Servayejc/Hardware/Parts.xlsx

Sheet: Sheet1
# | Value | DK | Tot
C1 | 0.1uF | Digi-Key 478-1831-ND | 1 | Découplage alim analog I/O
C12 | 0.1uF | Digi-Key 478-1831-ND | 1 | Découplage alimentation
C17 | 0.1uF | Digi-Key 478-1831-ND | 1 | Découplage alimentation
C3 | 0.1uF | Digi-Key 478-1831-ND | 1 | Découplage alimentation
C4 | 0.1uF | Digi-Key 478-1831-ND | 1 | Découplage alimentation
C5 | 0.1uF | Digi-Key 478-1831-ND | 1 | Découplage alimentation
C6 | 0.1uF | Digi-Key 478-1831-ND | 1 | Découplage alimentation
C8 | 0.1uF | Digi-Key 718-1208-ND | 1 | Découplage alimentation
 | 0.1uF Total |  | 8
C13 | 100nF | Digi-Key BC1621-ND | 1 | Découplage Ethernet
C14 | 100nF | Digi-Key BC1621-ND | 1 | Découplage Ethernet
C2 | 100nF | Digi-Key BC1621-ND | 1 | Reset par le port série
 | 100nF Total |  | 3
R24 | 10K |  | 1 | Pull-up interrupt Ethernet
 | 10K Total |  | 1
C15 | 15pF |  | 1 | Oscillateur Ethernet
C16 | 15pF |  | 1 | Oscillateur Ethernet
 | 15pF Total |  | 2
X2 | 16MHz | Digi-Key X1103-ND | 1 | Oscillateur Processeur
 | 16MHz Total |  | 1
R18 | 18R |  | 1 | Alimentation Ethernet
 | 18R Total |  | 1
R13 | 1K |  | 1 | Limitation courant LED
R14 | 1K |  | 1 | N/A
 | 1K Total |  | 2
R11 | 220R |  | 1 | Limitation courant LED
R21 | 220R |  | 1 | Limitation courant LED
R22 | 220R |  | 1 | Limitation courant LED
R7 | 220R |  | 1 | Limitation courant LED
R8 | 220R |  | 1 | Limitation courant LED
R9 | 220R |  | 1 | Découplage alim analog I/O
 | 220R Total |  | 6
C10 | 22pF |  | 1 | Oscillateur processeur
C11 | 22pF |  | 1 | Oscillateur processeur
 | 22pF Total |  | 2
X3 | 25MHz | Digi-Key X1103-ND | 1 | Oscillateur Ethernet
 | 25MHz Total |  | 1
R4 | 2K2 |  | 1 | Pull-up one-wire
R5 | 2K2 |  | 1 | Pull-up one-wire
 | 2K2 Total |  | 2
R23 | 2K4 |  | 1 | Polarisation Ethernet
 | 2K4 Total |  | 1
Q3 | 2N2222 | Digi-Key P2N2222AGOS-ND | 1 | Contrôle LED DO13
 | 2N2222 Total |  | 1
B1 | 3.3v | Digi-Key P033-ND = BAT-HLD-012-THM-ND | 1 | Batterie RTC
 | 3.3v Total |  | 1
X1 | 32768 KHz | DigiKey 728-1000-ND | 1 | Oscillateur RTC
 | 32768 KHz Total |  | 1
R16 | 47R |  | 1 | Polarisation Ethernet
R17 | 47R |  | 1 | Polarisation Ethernet
R19 | 47R |  | 1 | Polarisation Ethernet
R20 | 47R |  | 1 | Polarisation Ethernet
 | 47R Total |  | 4
C7 | 47uF | Digi-Key 399-3661-ND | 1 | Découplage alim 12V
C9 | 47uF | Digi-Key 399-3661-ND | 1 | Découplage alim Ethernet
 | 47uF Total |  | 2
R1 | 4K7 |  | 1 | Pull-up SCL I2C
R10 | 4k7 |  | 1 | Reset pull-up
R12 | 4K7 |  | 1 | Limitation courant base
R15 | 4K7 |  | 1
R2 | 4K7 |  | 1 | Pull-up SDA I2C
R3 | 4K7 |  | 1 | N/A
R6 | 4K7 |  | 1 | N/A
 | 4K7 Total |  | 7
U9 | 74LS125 |  | 1 | Buffer pour passer de 3.3 à 5V
 | 74LS125 Total |  | 1
J3 | 90 degre pins |  | 1
 | 90 degre pins Total |  | 1
J1 | Adafruit Shield stacking headers for Arduino (R3 Compatible) - ID: 85 |  | 1
J2 | Adafruit Shield stacking headers for Arduino (R3 Compatible) - ID: 85 |  | 1
J6 | Adafruit Shield stacking headers for Arduino (R3 Compatible) - ID: 85 |  | 1
J7 | Adafruit Shield stacking headers for Arduino (R3 Compatible) - ID: 85 |  | 1
 | Adafruit Shield stacking headers for Arduino (R3 Compatible) - ID: 85 Total |  | 4
U1 | ATMEGA1284 | Digi-Key ATMEGA1284P-PU-ND | 1 | Processeur
 | ATMEGA1284 Total |  | 1
Q1 | BS250 | Degi-Key BS250P-ND | 1 | Inverseur LED RXD
Q2 | BS250 | Digi-Key BS250P-ND | 1 | Inverseur LED TXD
 | BS250 Total |  | 2
J13 | Conn alim | Digi-Key CP-202A-ND | 1
 | Conn alim Total |  | 1
J8 | Conn RJ45 | Digi Key RJSBE5381C1-ND | 1
 | Conn RJ45 Total |  | 1
J10 | Conn vis 10 | Digi-Key A98074-ND | 1
J11 | Conn vis 10 | Digi-Key A98074-ND | 1
J2B | Conn vis 10 | Digi-Key A98074-ND | 1
J5 | Conn vis 10 | Digi-Key A98074-ND | 1
 | Conn vis 10 Total |  | 4
J4 | Conn vis 6 | Digi-Key A98337-ND | 1
J7B | Conn vis 6 | Digi-Key A98337-ND | 1
J9 | Conn vis 6 | Digi-Key A98337-ND | 1
 | Conn vis 6 Total |  | 3
J1B | Conn vis 8 | Digi-Key A98338-ND | 1
J6B | Conn vis 8 | Digi-Key A98338-ND | 1
 | Conn vis 8 Total |  | 2
D1 | Diode | Digi-Key 641-1310-1-ND | 1
D6 | Diode | Digi-Key 641-1310-1-ND | 1 | Reset pull-up
 | Diode Total |  | 2
U3 | DS1307 | DigiKey DS1307+-ND | 1 | RTC
 | DS1307 Total |  | 1
U7 | ENC28J60 | Digi-Key ENC28J60-I/SP-ND | 1 | Ethernet
 | ENC28J60 Total |  | 1
D3 | Green LED |  | 1
 | Green LED Total |  | 1
U2 | LM3940 | Digi-Key 296-36109-5-ND | 1 | Alim 3.3V
 | LM3940 Total |  | 1
U4 | LM7805 | Digi-Key LM7805CT-ND | 1 | Alim 5V
 | LM7805 Total |  | 1
D4 | Orange LED |  | 1
 | Orange LED Total |  | 1
U5 | PCA8574A | DigiKey 568-4236-5-ND | 1 | Extension I/O
U6 | PCA8574A | 568-4236-5-ND | 1 | Extension I/O
 | PCA8574A Total |  | 2
J12 | Pins | Digi-Key S7071-ND | 1
 | Pins Total |  | 1
D5 | Red |  | 1
 | Red Total |  | 1
D2 | Red LED |  | 1
 | Red LED Total |  | 1
SW1 | Reset | Digi-Key 450-1650-ND | 1 | Bouton Reset
 | Reset Total |  | 1
JP1
JP2
JP3
 | Grand Total |  | 80

Sheet: Sheet2
C1 | 0.1uF | Digi-Key 478-1831-ND | 8
C2 | 100nF | Digi-Key BC1621-ND | 3
R24 | 10K |  | 1
C16 | 15pF |  | 2
X2 | 16MHz | Digi-Key X1103-ND | 1
R18 | 18R |  | 1
R14 | 1K |  | 2
R9 | 220R |  | 6
C11 | 22pF |  | 2
X3 | 25MHz | Digi-Key X1103-ND | 1
R5 | 2K2 |  | 2
R23 | 2K7 |  | 1
Q3 | 2N2222 | Digi-Key P2N2222AGOS-ND | 1
B1 | 3.3v | Digi-Key P033-ND = BAT-HLD-012-THM-ND | 1
X1 | 32768 KHz | DigiKey 728-1000-ND | 1
R20 | 47R |  | 4
C9 | 47uF | Digi-Key 399-3661-ND | 2
R6 | 4K7 |  | 7
U9 | 74LS125 |  | 1
J3 | 90 degre pins |  | 1
J1 | Adafruit Shield stacking headers for Arduino (R3 Compatible) - ID: 85 |  | 1
U1 | ATMEGA1284 | Digi-Key ATMEGA1284P-PU-ND | 1
Q2 | BS250 | Digi-Key BS250P-ND | 2
J13 | Conn alim | Digi-Key CP-202A-ND | 1
J8 | Conn RJ45 | Digi Key RJSBE5381C1-ND | 1
J5 | Conn vis 10 | Digi-Key A98074-ND | 4
J4 | Conn vis 6 | Digi-Key A98337-ND | 3
J1B | Conn vis 8 | Digi-Key A98338-ND | 2
D1 | Diode | Digi-Key 641-1310-1-ND | 2
U3 | DS1307 | DigiKey DS1307+-ND | 1
U7 | ENC28J60 | Digi-Key ENC28J60-I/SP-ND | 1
D3 | Green LED |  | 1
U2 | LM3940 | Digi-Key 296-36109-5-ND | 1
U4 | LM7805 | Digi-Key LM7805CT-ND | 1
D4 | Orange LED |  | 1
U5 | PCA8574A | DigiKey 568-4236-5-ND | 2
J12 | Pins | Digi-Key S7071-ND | 1
D5 | Red |  | 1
D2 | Red LED |  | 1
SW1 | Reset | Digi-Key 450-1650-ND | 1

Sheet: Sheet3
B1 | 3.3v | Digi-Key P033-ND = BAT-HLD-012-THM-ND | 1 |  | 0.33 |  | 0.33
C1 | 0.1uF | Digi-Key 478-1831-ND | 8 |  | 1.06 |  | 8.48
C11 | 22pF |  | 2 |  |  |  | 0
C16 | 15pF |  | 2 |  |  |  | 0
C2 | 100nF | Digi-Key BC1621-ND | 3 |  | 0.54 |  | 1.62
C9 | 47uF | Digi-Key 399-3661-ND | 2 |  | 3 |  | 6
D1 | Diode | Digi-Key 641-1310-1-ND | 2 |  | 0.13 |  | 0.26
D2 | Red LED |  | 1 |  |  |  | 0
D3 | Green LED |  | 1 |  |  |  | 0
D4 | Orange LED |  | 1 |  |  |  | 0
D5 | Red |  | 1 |  |  |  | 0
J1 | Adafruit Shield stacking headers for Arduino (R3 Compatible) - ID: 85 |  | 1 |  |  |  | 0
J12 | Pins | Digi-Key S7071-ND | 1 |  |  | LowCost | 0
J13 | Conn alim | Digi-Key CP-202A-ND | 1 |  | 1.12 |  | 1.12
J1B | Conn vis 8 | Digi-Key A98338-ND | 2 | 6.82 | 2.2 | ED10566-ND | 4.4 | 20.3 | 47.28
J3 | 90 degre pins |  | 1 |  |  |  | 0
J4 | Conn vis 6 | Digi-Key A98337-ND | 3 | 4.36 | 1.66 | ED10565-ND | 4.98
J5 | Conn vis 10 | Digi-Key A98074-ND | 4 | 5.14 | 2.73 | ED10567-ND | 10.92
J8 | Conn RJ45 | Digi Key RJSBE5381C1-ND | 1 |  | 3.49 |  | 3.49
Q2 | BS250 | Digi-Key BS250P-ND | 2 |  | 1.06 |  | 2.12
Q3 | 2N2222 | Digi-Key P2N2222AGOS-ND | 1 |  | 0.51 |  | 0.51
R14 | 1K |  | 2 |  |  |  | 0
R18 | 18R |  | 1 |  |  |  | 0
R20 | 47R |  | 4 |  |  |  | 0
R23 | 2K7 |  | 1 |  |  |  | 0
R24 | 10K |  | 1 |  |  |  | 0
R5 | 2K2 |  | 2 |  |  |  | 0
R6 | 4K7 |  | 7 |  |  |  | 0
R9 | 220R |  | 6 |  |  |  | 0
SW1 | Reset | Digi-Key 450-1650-ND | 1 |  | 0.13 |  | 0.13
U1 | ATMEGA1284 | Digi-Key ATMEGA1284P-PU-ND | 1 |  | 9.03 |  | 9.03
U2 | LM3940 | Digi-Key 296-36109-5-ND | 1 |  | 2.52 |  | 2.52
U3 | DS1307 | DigiKey DS1307+-ND | 1 |  | 5.1 |  | 5.1
U4 | LM7805 | Digi-Key LM7805CT-ND | 1 |  | 0.81 |  | 0.81
U5 | PCA8574A | DigiKey 568-4236-5-ND | 2 |  | 5 |  | 10
U7 | ENC28J60 | Digi-Key ENC28J60-I/SP-ND | 1 |  | 4.38 |  | 4.38
U9 | 74LS125 | Digi-Key 296-1638-5-ND | 1 |  | 1.04 |  | 1.04
X1 | 32768 KHz | DigiKey 728-1000-ND | 1 |  | 0.36 |  | 0.36
X2 | 16MHz | Digi-Key X1103-ND | 1 |  | 0.98 |  | 0.98
X3 | 25MHz | Digi-Key CTX928-ND | 1 |  | 0.43 |  | 0.43
 | pins | Digi-Key 609-3461-ND |  |  |  |  | 0
 | 6 pins | Digi-Key S7004-ND | 1 |  | 0.82 |  | 0.82
 | 8 pins | Digi-Key S7006-ND | 4 |  | 1.04 |  | 4.16
 | 10 pins | Digi-Key S7008-ND | 1 |  | 0.98 |  | 0.98
 |  |  |  |  |  |  | 84.97
Relay |  | Digi-Key PB862-ND | 1 |  | 18.21
18B20 |  | Digi-Key DS18B20+-ND | 10 |  | 2.78

Sheet: Sheet4
All prices are in Canadian dollars.
Index | Quantity | Part Number | Description | Available Quantity | Unit Price | Extended Price
1 | 2 | BAT-HLD-012-THM-ND (http://www.digikey.ca/product-detail/en/BAT-HLD-012-THM/BAT-HLD-012-THM-ND/3044012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) | RETAINER BATT CR1216/1225 PC PIN | 2 | 0.32 | $0.64
 |  |  |  | Immediate
2 | 4 | 641-1310-1-ND (http://www.digikey.ca/product-detail/en/1N4001-G/641-1310-1-ND/1979675?itemSeq=145924733&uq=635299006594131277) | DIODE GEN PURPOSE 50V 1A DO41 | 4 | 0.13 | $0.52
 |  |  |  | Immediate
3 | 2 | 728-1000-ND (http://www.digikey.ca/product-detail/en/VT200F-6PF20PPM/728-1000-ND/1626715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) | CRYSTAL 32.768KHZ 6PF THRU | 2 | 0.36 | $0.72
 |  |  |  | Immediate
4 | 4 | P2N2222AGOS-ND (http://www.digikey.ca/product-detail/en/P2N2222AG/P2N2222AGOS-ND/920244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) | TRANS GP SS NPN LP 40V TO92 | 4 | 0.5 | $2.00
 |  |  |  | Immediate
5 | 2 | S7071-ND (http://www.digikey.ca/product-detail/en/PPTC032LFBN-RC/S7071-ND/810210?itemSeq=145924736&uq=635299006594131277) | CONN HEADER FMALE 6PS .1" DL TIN | 2 | 0.96 | $1.92
 |  |  |  | Immediate
6 | 16 | 478-1831-ND (http://www.digikey.ca/product-detail/en/TAP104K035SCS/478-1831-ND/563934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) | CAP TANT 0.1UF 35V 10% RADIAL | 16 | 0.554 | $8.86
 |  |  |  | Immediate
7 | 6 | BC1621-ND (http://www.digikey.ca/product-detail/en/BFC237011104/BC1621-ND/502401?itemSeq=145924738&uq=635299006594131277) | CAP FILM 0.1UF 63VDC RADIAL | 6 | 0.54 | $3.24
 |  |  |  | Immediate
8 | 2 | CP-202A-ND (http://www.digikey.ca/product-detail/en/PJ-202A/CP-202A-ND/252007?itemSeq=145924739&uq=635299006594131277) | CONN POWER JACK 2.1MM PCB | 2 | 1.11 | $2.22
 |  |  |  | Immediate
9 | 2 | RJSBE5381C1-ND (http://www.digikey.ca/product-detail/en/RJSBE5381C1/RJSBE5381C1-ND/1979564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) | CONN MOD JACK R/A 8P8C SHIELDED | 2 | 3.48 | $6.96
 |  |  |  | Immediate
10 | 4 | BS250P-ND (http://www.digikey.ca/product-detail/en/BS250P/BS250P-ND/92630?itemSeq=145924741&uq=635299006594131277) | MOSFET P-CH 45V 230MA TO92-3 | 4 | 1.05 | $4.20
 |  |  |  | Immediate
11 | 1 | ATMEGA1284P-PU-ND (http://www.digikey.ca/product-detail/en/ATMEGA1284P-PU/ATMEGA1284P-PU-ND/1914521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) | IC MCU 8BIT 128KB FLASH 40DIP | 1 | 9.97 | $9.97
 |  |  |  | Immediate
12 | 2 | 296-36109-5-ND (http://www.digikey.ca/product-detail/en/LM3940IT-3.3/296-36109-5-ND/3695215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) | IC REG LDO 3.3V 1A TO220-3 | 2 | 2.5 | $5.00
 |  |  |  | Immediate
13 | 2 | LM7805CT-ND (http://www.digikey.ca/product-detail/en/LM7805CT/LM7805CT-ND/458698?itemSeq=145924744&uq=635299006594131277) | IC REG LDO 5V 1A TO220-3 | 2 | 0.8 | $1.60
 |  |  |  | Immediate
14 | 2 | ENC28J60-I/SP-ND (http://www.digikey.ca/product-detail/en/ENC28J60-I%2fSP/ENC28J60-I%2fSP-ND/1680061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) | IC ETHERNET CTRLR W/SPI 28SDIP | 2 | 4.36 | $8.72
 |  |  |  | Immediate
15 | 2 | 296-1638-5-ND (http://www.digikey.ca/product-detail/en/SN74LS125AN/296-1638-5-ND/277284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) | IC BUS BUFF TRI-ST QD 14DIP | 2 | 1.03 | $2.06
 |  |  |  | Immediate
16 | 1 | X1103-ND (http://www.digikey.ca/product-detail/en/ECS-160-20-4X/X1103-ND/827594?itemSeq=145924747&uq=635299006594131277) | CRYSTAL 16MHZ 20PF THRU | 1 | 0.97 | $0.97
 |  |  |  | Immediate
17 | 2 | CTX928-ND (http://www.digikey.ca/product-detail/en/ATS250B-E/CTX928-ND/2292924?itemSeq=145924748&uq=635299006594131277) | CRYSTAL 25MHZ 18PF THRU | 2 | 0.43 | $0.86
 |  |  |  | Immediate
18 | 6 | 609-3461-ND (http://www.digikey.ca/product-detail/en/68000-103HLF/609-3461-ND/2023309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) | BERGSTIK II .100" SR STRAIGHT | 6 | 0.18 | $1.08
 |  |  |  | Immediate
19 | 2 | S7004-ND (http://www.digikey.ca/product-detail/en/PPTC061LFBN-RC/S7004-ND/810145?itemSeq=145924750&uq=635299006594131277) | CONN HEADER FEMALE 6POS .1" TIN | 2 | 0.81 | $1.62
 |  |  |  | Immediate
20 | 8 | S7006-ND (http://www.digikey.ca/product-detail/en/PPTC081LFBN-RC/S7006-ND/810147?itemSeq=145924751&uq=635299006594131277) | CONN HEADER FEMALE 8POS .1" TIN | 8 | 1.03 | $8.24
 |  |  |  | Immediate
21 | 2 | S7008-ND (http://www.digikey.ca/product-detail/en/PPTC101LFBN-RC/S7008-ND/810149?itemSeq=145924752&uq=635299006594131277) | CONN HEADER FEMALE 10POS.1" TIN | 2 | 0.97 | $1.94
 |  |  |  | Immediate
22 | 2 | PB862-ND (http://www.digikey.ca/product-detail/en/MT226024/PB862-ND/1095187?itemSeq=145924753&uq=635299006594131277) | RELAY GEN PURPOSE DPDT 10A 24V | 2 | 18.12 | $36.24
 |  |  |  | Immediate
23 | 10 | DS18B20+T&RCT-ND (http://www.digikey.ca/product-detail/en/DS18B20%2bT%26R/DS18B20%2bT%26RCT-ND/3478852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) | IC THERM MICROLAN PROG-RES TO92 | 10 | 5.043 | $50.43
 |  |  |  | Immediate
24 | 4 | ED10566-ND (http://www.digikey.ca/product-detail/en/OSTVN08A150/ED10566-ND/1588868?itemSeq=145924755&uq=635299006594131277) | CONN TERM BLOCK 2.54MM 8POS PCB | 4 | 2.2 | $8.80
 |  |  |  | Immediate
25 | 6 | ED10565-ND (http://www.digikey.ca/product-detail/en/OSTVN06A150/ED10565-ND/1588866?itemSeq=145924756&uq=635299006594131277) | CONN TERM BLOCK 2.54MM 6POS PCB | 0 | 1.65 | $9.90
 |  |  |  | Immediate
26 | 8 | ED10567-ND (http://www.digikey.ca/product-detail/en/OSTVN10A150/ED10567-ND/1588870?itemSeq=145924757&uq=635299006594131277) | CONN TERM BLOCK 2.54MM 10POS PCB | 0 | 2.72 | $21.76
 |  |  |  | Immediate
27 | 4 | 478-4181-ND (http://www.digikey.ca/product-detail/en/TAP476K025CCS/478-4181-ND/1212736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) | CAP TANT 47UF 25V 10% RADIAL | 4 | 4.65 | $18.60
 |  |  |  | Immediate
28 | 2 | 1N4148TACT-ND (http://www.digikey.ca/product-detail/en/1N4148TA/1N4148TACT-ND/1532747?itemSeq=145926018&uq=635299006594131277) | DIODE SMALL SIG 100V 0.2A DO35 | 2 | 0.12 | $0.24
 |  |  |  | Immediate

Sheet: Sheet6
http://www.geeetech.com/wiki/index.php/Arduino_ENC28J60_Ethernet_Module
http://jeelabs.net/pub/docs/ethercard/
