Servayejc/Hardware/(list of files, drawings)

Other design files:
Display proto.pcb
Display.pcb
Tempuino2.pcb
Tempuino.pcb
Thermostats.pcb
