Servayejc/Hardware/Tests Report.xlsx

Signal | Conn. | Pin | Status | Used by | Jumper | Left | Right
Uploading | J3 |  | Ok
Reset | J6 |  | Ok
Power supply | J6 | 5V | Ok |  | JP3 | J3 | J13
Power supply | J6 | 3.3V | Ok
Ethernet | J8 | SMTP | Ok
Ethernet | J8 | Server HTTP | Ok
Ethernet | J8 | Client HTTP | Ok
Ethernet | J8 | Interrupt | Ok |  | JP4 | INT0 | Disabled
1-Wire | J4 | Read I2 Address | Ok
1-Wire | J4 | Read temp | Ok
I2C | J11 | Extension A (X0-X7) | Ok
I2C | J9 | Ext A interrupt | Ok
I2C | J11 | Extension B (X8-X15) | Ok
I2C | J9 | Ext B interrupt | Ok
I2C |  | RTC | Ok
I2C | J9 | RTC interrupt | Ok
Analog | J7 | A0 | Ok
Analog | J7 | A1 | Ok
Analog | J7 | A2 | Ok
Analog | J7 | A3 | Ok
Analog | J7 | A4 | Ok |  | JP1 | A4 | SDA
Analog | J7 | A5 | Ok |  | JP2 | A5 | SCL
Analog | J9 | A6 | Ok
Analog | J9 | A7 | Ok
Digital | J1 | 0 | Ok | RXD
Digital | J1 | 1 | Ok | TXD
Digital | J1 | 2 INT0 | Ok | See JP4
Digital | J1 | 3 INT1 | Ok
Digital | J1 | 4 | Ok
Digital | J1 | 5 | Ok | 1-Wire B
Digital | J1 | 6 INT2 | Ok | 1-Wire A
Digital | J1 | 7 | Ok
Digital | J2 | 8 | Ok
Digital | J2 | 9 | Ok
Digital | J2 | 10 | Ok | Ethernet CS
Digital | J2 | 11 | Ok | MOSI
Digital | J2 | 12 | Ok | MISO
Digital | J2 | 13 | Ok | SCK
Digital | J5 | 14 | Ok
Digital | J5 | 15 | Ok
Digital | J5 | 16 | Ok
Digital | J5 | 17 | Ok
Digital | J5 | 18 | Ok
Digital | J5 | 19 | Ok
Digital | J5 | 20 | Ok | 1-Wire SDA
Digital | J5 | 21 | Ok | 1-Wire SCL
Digital | J5 | 22 | Ok
Digital | J5 | 23 | Ok
