Servayejc/Hardware/(commit log)

2015-01-30 Display is now connected
    [Display proto.pcb]
2015-01-30 Add PCB
    [Display.pcb, Tempuino.pcb, Tempuino2.pcb, Thermostats.pcb]
2015-01-30 Add JoyStick
    [Display proto.pcb]
